JamesGossy/stm32_motor_controller/bench_stm32_esc/bench_stm32_esc.kicad_pcb

## KiCad design bench_stm32_esc/bench_stm32_esc.kicad_pcb (2026-04-23)

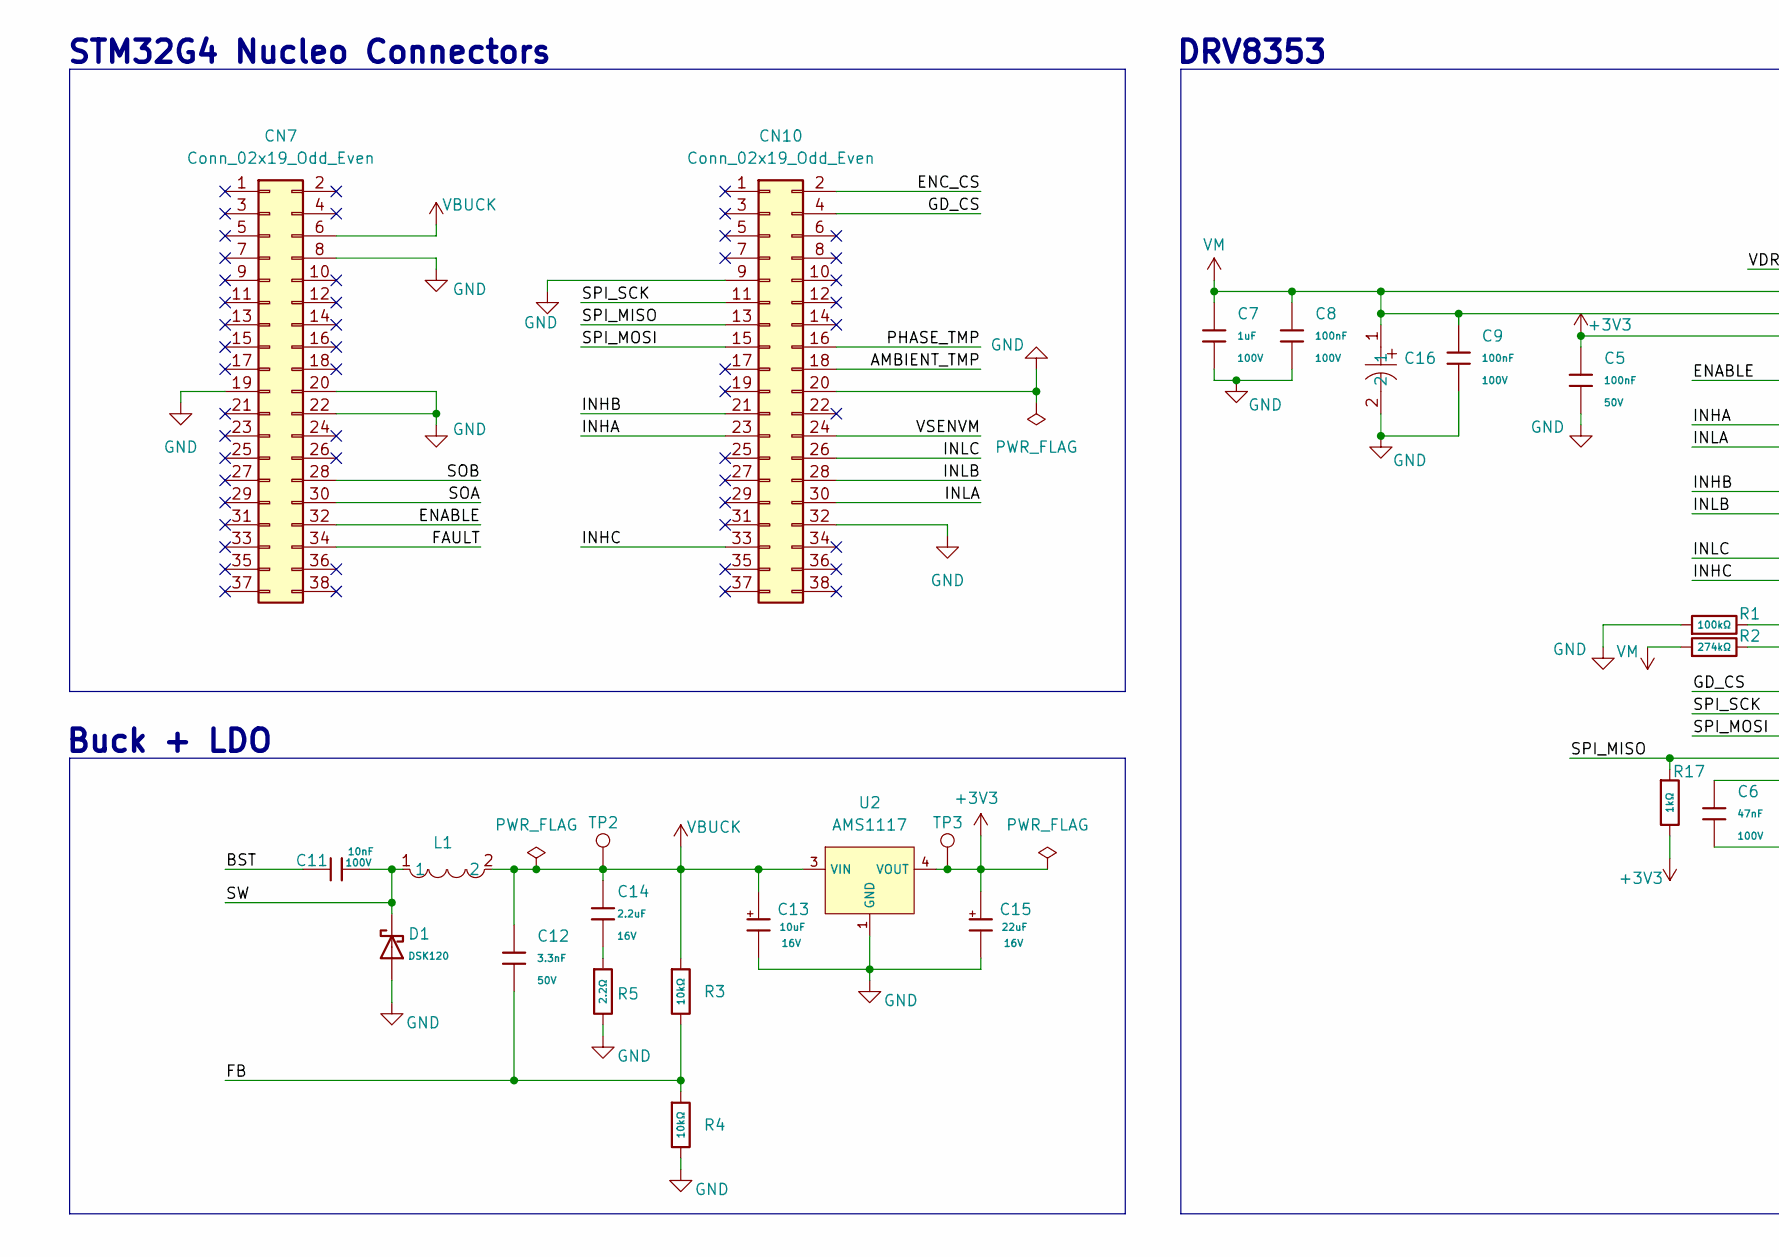
[picture p1: schematic bench_stm32_esc.kicad_sch, part in row 1, column 1]

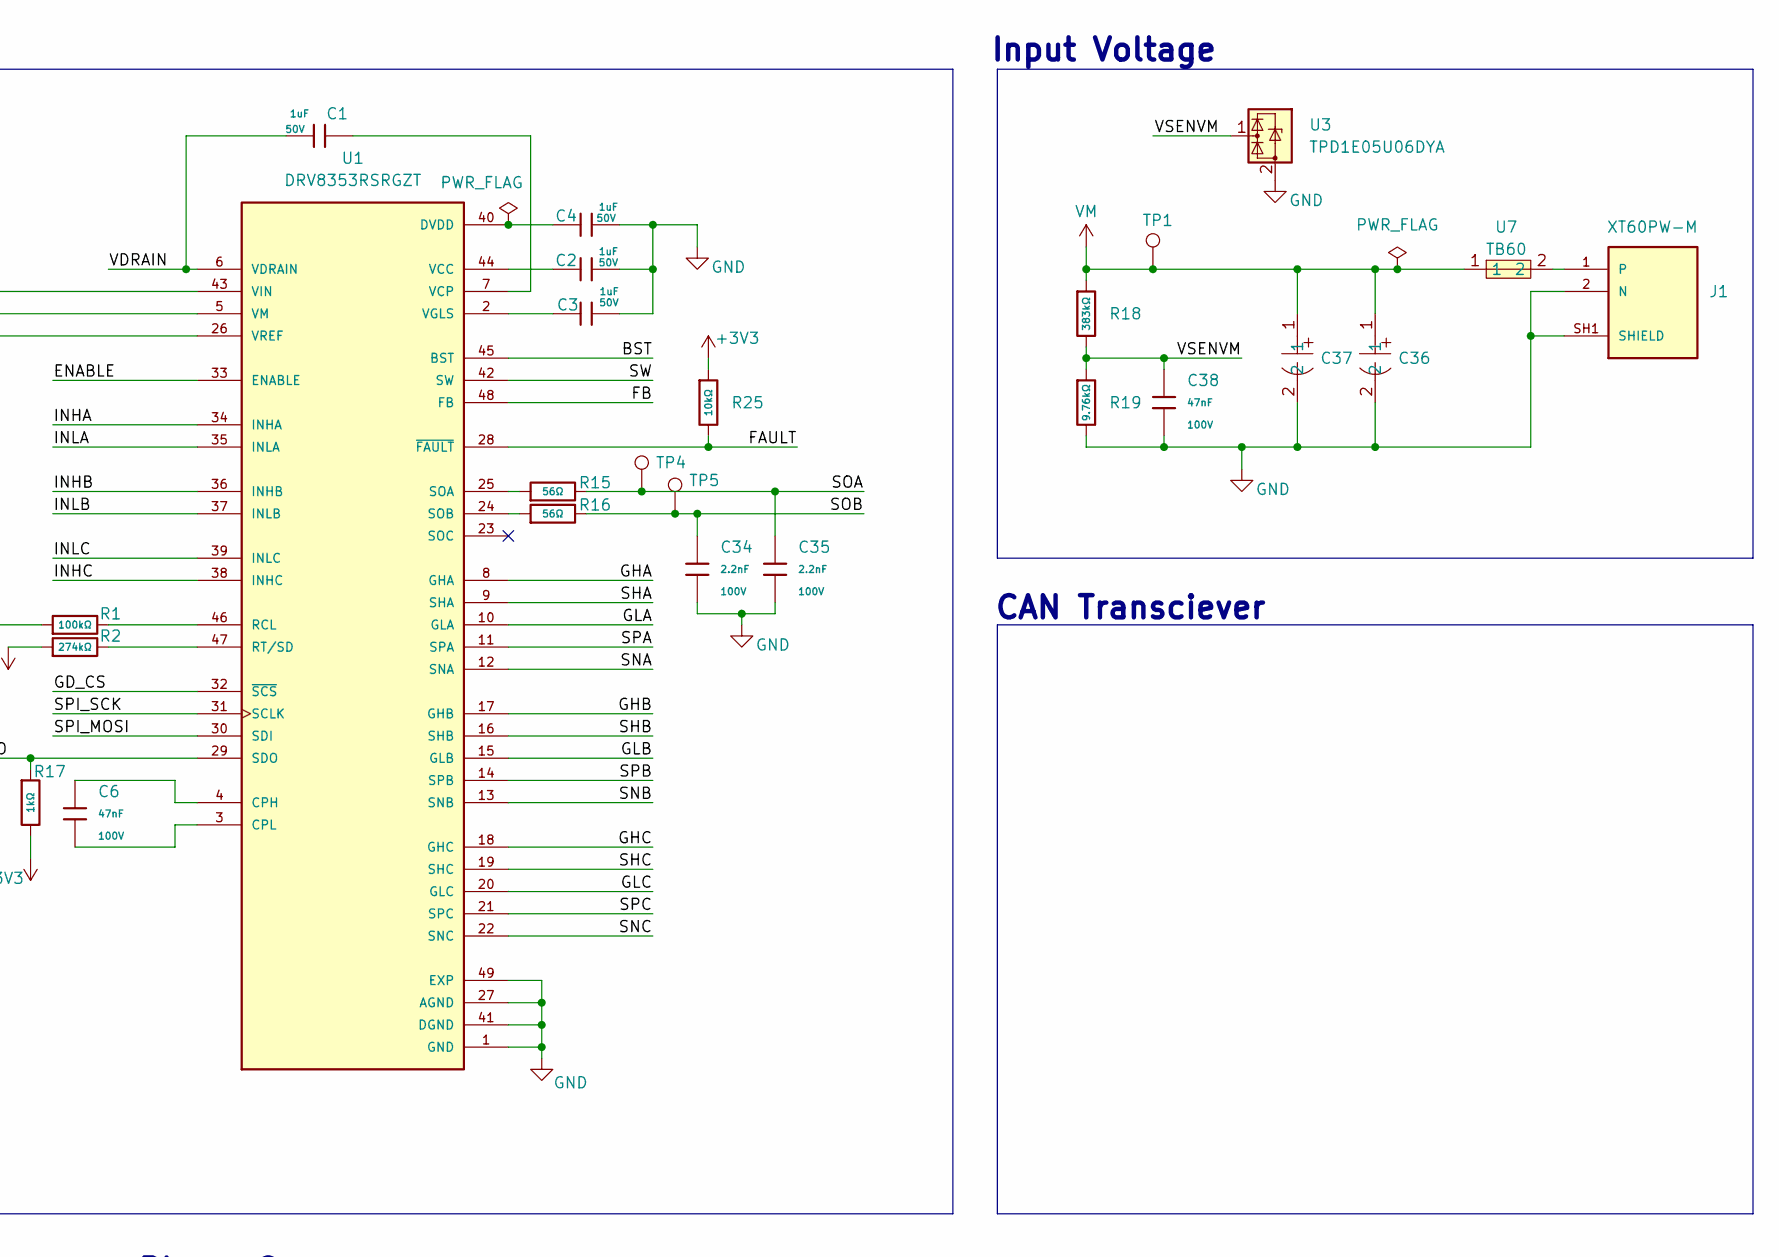
[picture p2: schematic bench_stm32_esc.kicad_sch, part in row 1, column 2]

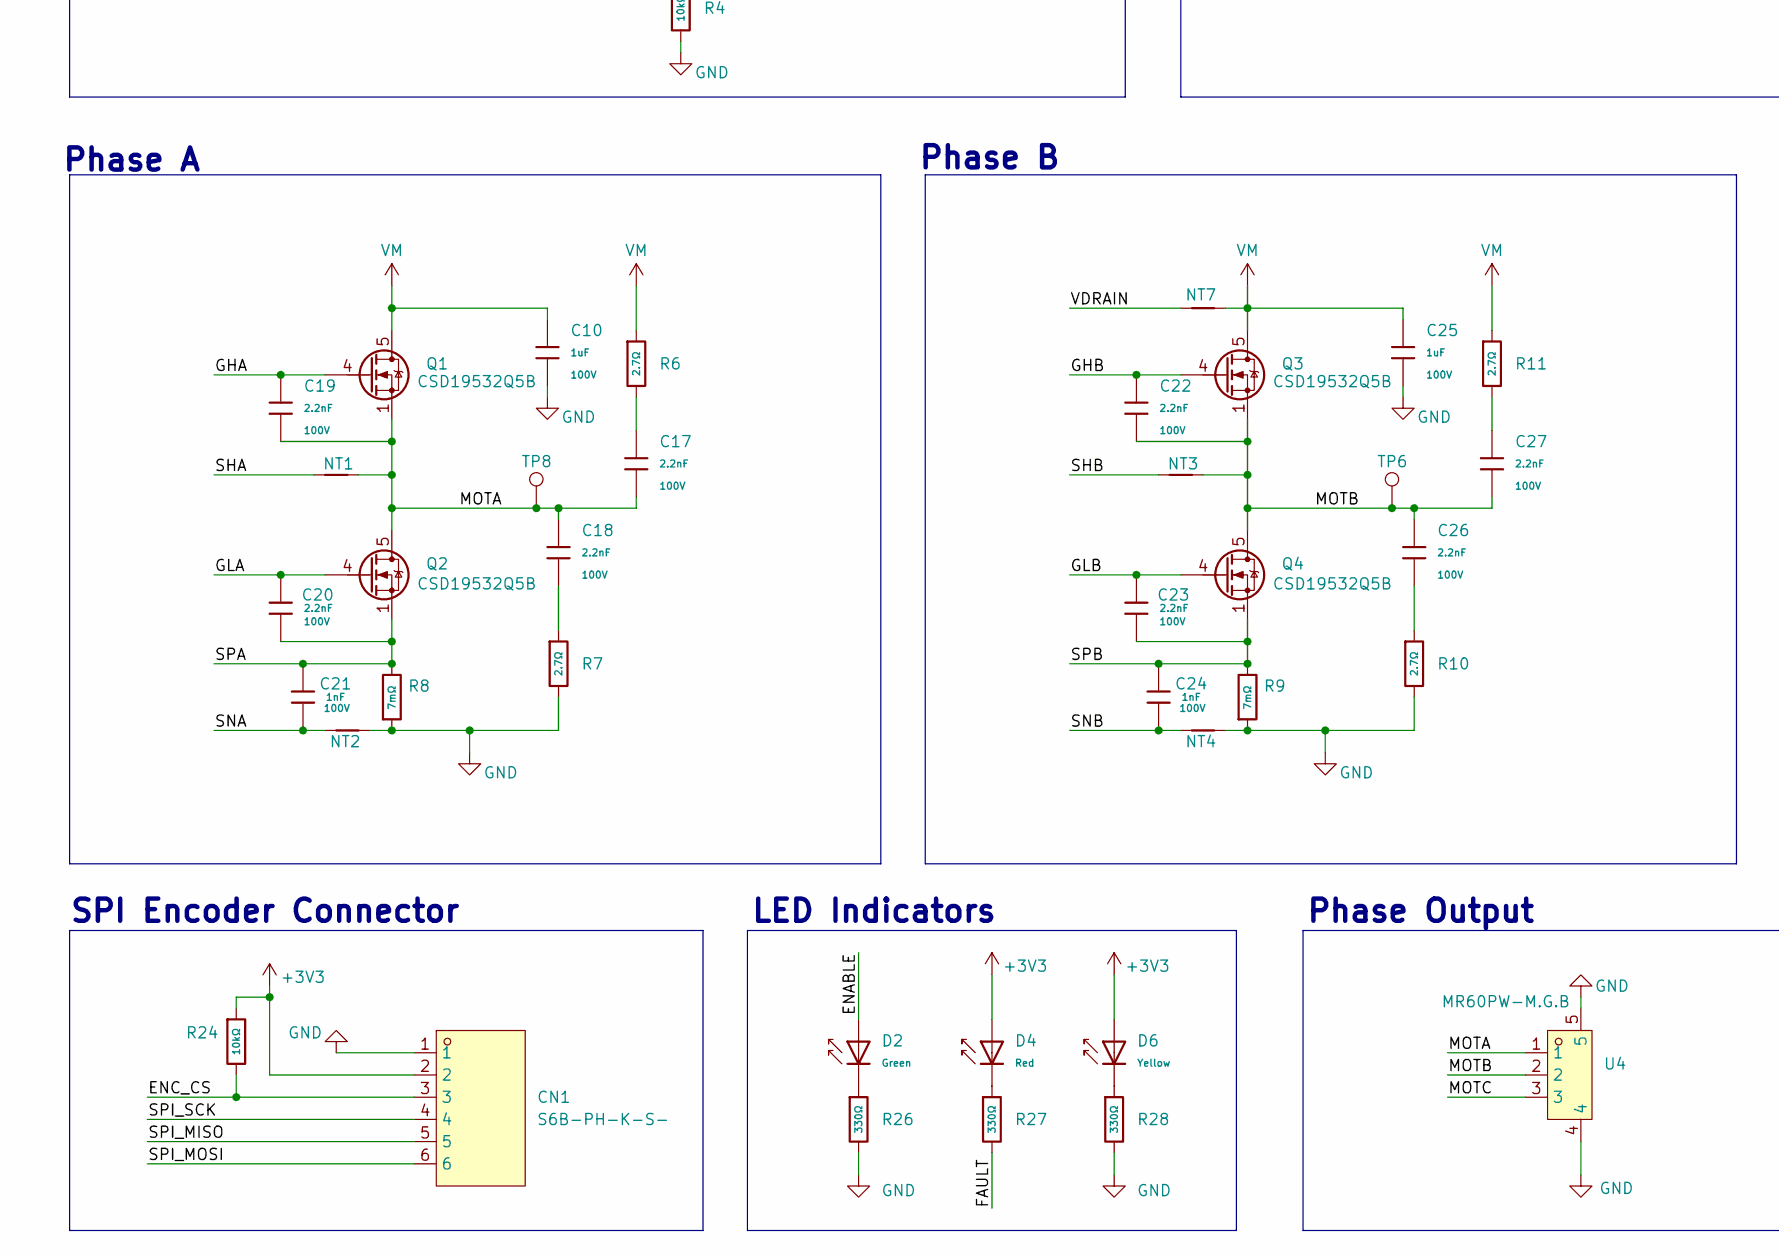
[picture p3: schematic bench_stm32_esc.kicad_sch, part in row 2, column 1]

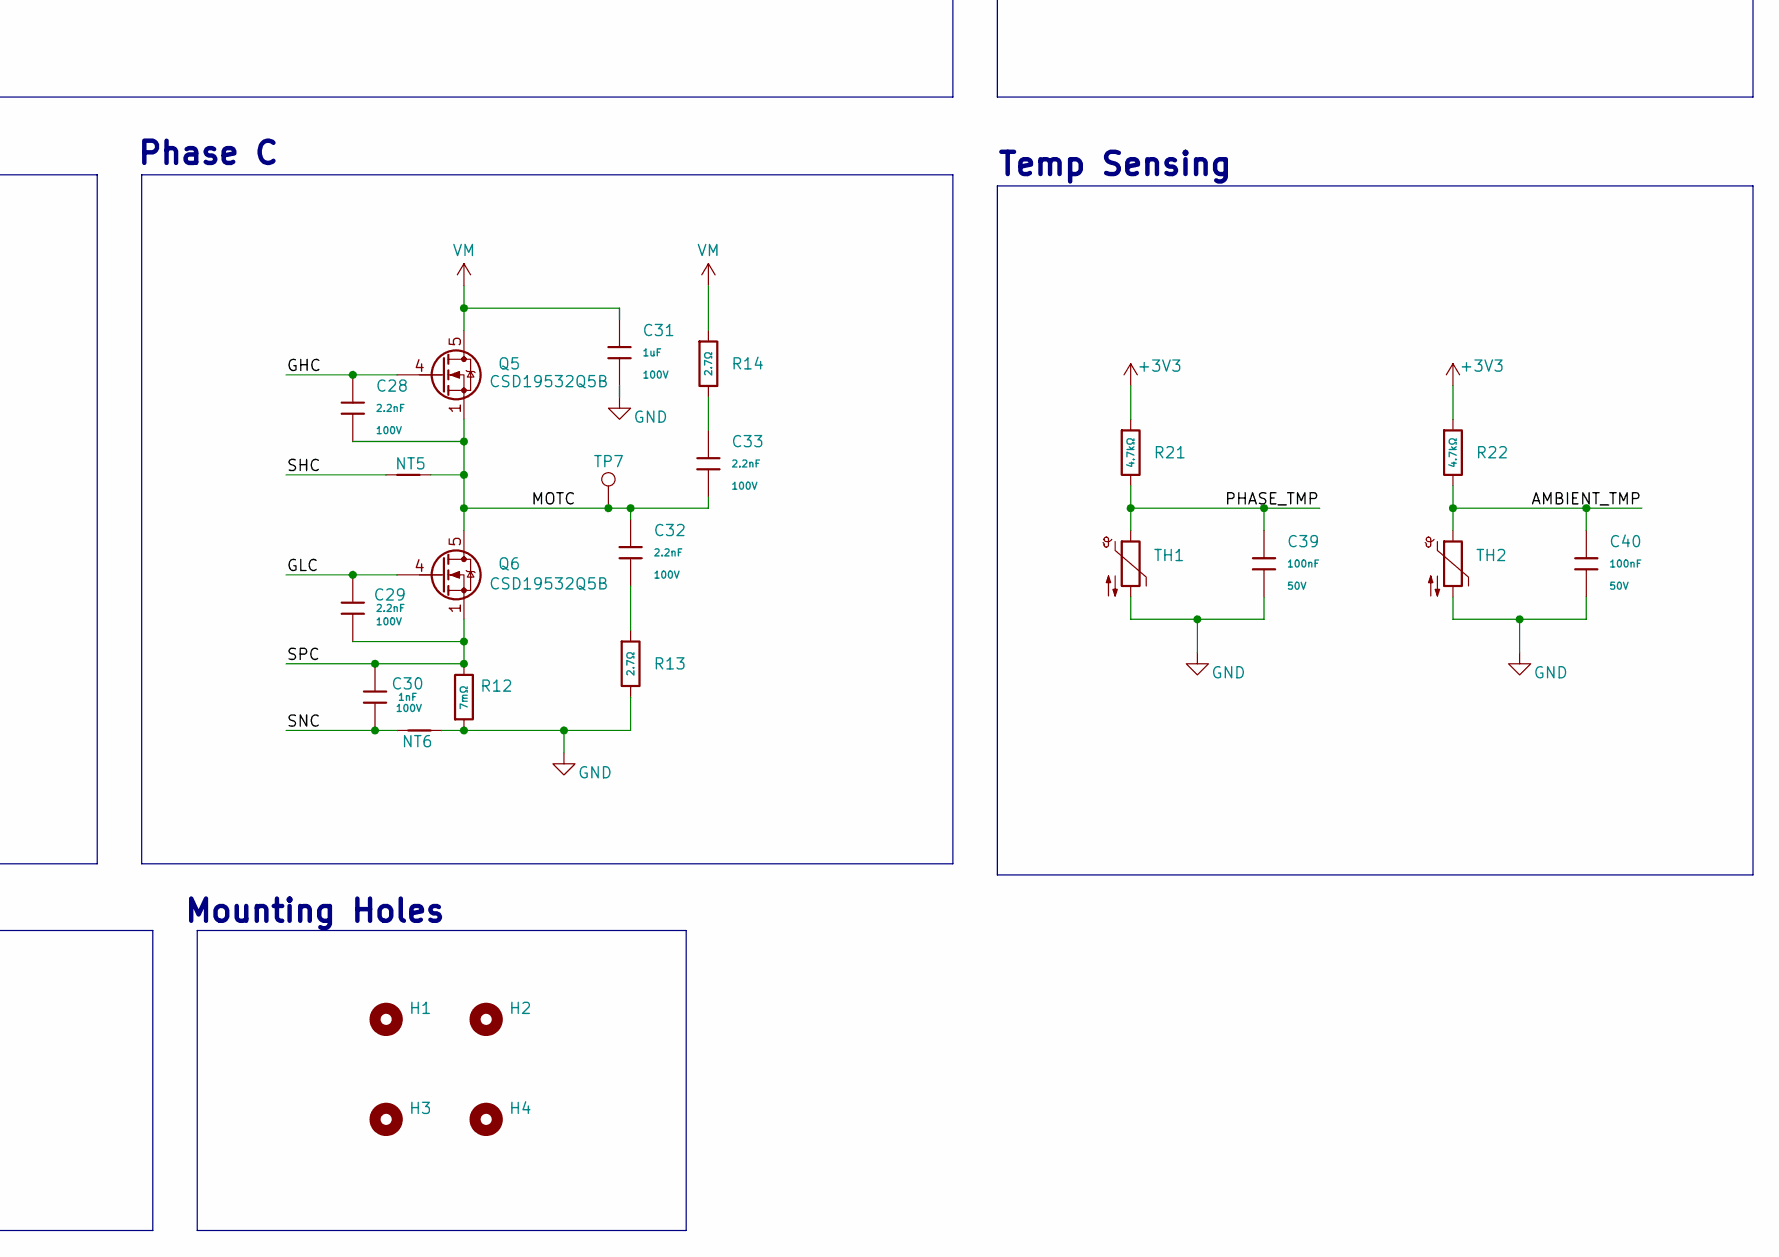
[picture p4: schematic bench_stm32_esc.kicad_sch, part in row 2, column 2]

Parts:
C1, C2, C3, C4: 1uF; C_0603; Voltage Rated 50V; Tolerance ±10%; Part CL10A105KB8NNNC; LCSC C15849
C5, C39, C40: 100nF; C_0603; Voltage Rated 50V; Tolerance ±10%; Part CC0603KRX7R9BB104; LCSC C14663
C6, C38: 47nF; C_0603; Voltage Rated 100V; Tolerance ±10%; Part 0603B473K101CT; LCSC C559308
C7, C10, C25, C31: 1uF; C_0805; Voltage Rated 100V; Tolerance ±10%; Part GCM21BC72A105KE36L; LCSC C126585
C8, C9: 100nF; C_0603; Voltage Rated 100V; Tolerance ±10%; Part CL10B104KC8NNNC; LCSC C15725
C11: 10nF; C_0603; Voltage Rated 100V; Tolerance ±10%; LCSC C43253
C12: 3.3nF; C_0603; Voltage Rated 50V; Tolerance ±10%; Part CL10B332KB8NNNC; LCSC C1613
C13: 10uF; C_CASE-A-3216-18(mm); Tolerance ±10%; Rated Voltage 16V; Part TAJA106K016RNJ; LCSC C7171
C14: 2.2uF; C_0603; Voltage Rated 16V; Tolerance ±10%; Part CL10A225KO8NNNC; LCSC C23630
C15: 22uF; C_CASE-A-3216-18(mm); Tolerance ±10%; Rated Voltage 16V; LCSC C7183
C16: VT10UF100V167RV0127; MPN VT10UF100V167RV0127; LCSC Part C5250958
C17, C18, C19, C20, C22, C23, C26, C27, C28, C29, C32, C33, C34, C35: 2.2nF; C_0603; Voltage Rated 100V; Tolerance ±10%; Part CC0603KRX7R0BB222; LCSC C113804
C21, C24, C30: 1nF; C_0603; Voltage Rated 100V; Tolerance ±10%; Part 0603B102K101NT; LCSC C43847
C36, C37: VEJ331M2ATR-1816; LCSC Part C5266054
CN1: S6B-PH-K-S-; S6B-PH-K-S(LF)(SN); MPN S6B-PH-K-S(LF)(SN); LCSC Part C157920
CN7, CN10: Conn_02x19_Odd_Even; PinSocket_2x19_P2.54mm_Vertical; LCSC C2881762
D1: DSK120; D_SOD-123FL; Part DSK120; LCSC C22466355
D2: Green; D_0805; Part KT-0805G; LCSC C2297
D4: Red; D_0805; Forward Voltage (VF) 1.6V~2.6V; Part NCD0805R1; LCSC C84256
D6: Yellow; D_0805; Part KT-0805Y; LCSC C2296
H1, H2, H3, H4: MountingHole; MountingHole_3.2mm_M3
J1: XT60PW-M; AMASS_XT60PW-M; PARTREV 1.2; LCSC C98732
L1: SMDRH104R-331MT; LCSC Part C10146
NT1, NT2, NT3, NT4, NT5, NT6: NetTie_2; NetTie-2_SMD_Pad0.5mm
NT7: NetTie_2; NetTie-2_SMD_Pad2.0mm
Q1, Q2, Q3, Q4, Q5, Q6: CSD19532Q5B; TDSON-8-1; LCSC C2832190
R1: 100kΩ; R_0603; Tolerance ±1%; LCSC C25803
R2: 274kΩ; R_0603; Tolerance ±1%; LCSC C22968
R3, R4, R24, R25: 10kΩ; R_0603; Overload Voltage (Max) 75V; Tolerance ±1%; Part 0603WAF1002T5E; LCSC C25804
R5: 2.2Ω; R_0603; Overload Voltage (Max) 75V; Tolerance ±1%; Part 0603WAF220KT5E; LCSC C22939
R6, R7, R10, R11, R13, R14: 2.7Ω; R_0805; Overload Voltage (Max) 150V; Tolerance ±1%; Part 0805W8F270KT5E; LCSC C17532
R8, R9, R12: 7mΩ; R_2512_6332Metric; Part No RLP25FEGMR007; LCSC C393073
R15, R16: 56Ω; R_0603; Overload Voltage (Max) 75V; Tolerance ±1%; Part 0603WAF560JT5E; LCSC C25196
R17: 1kΩ; R_0603; Overload Voltage (Max) 75V; Tolerance ±1%; Part 0603WAF1001T5E; LCSC C21190
R18: 383kΩ; R_0805; Overload Voltage (Max) 150V; Tolerance ±1%; Part 0805W8F3833T5E; LCSC C17652
R19: 9.76kΩ; R_0805; Overload Voltage (Max) 150V; Tolerance ±1%; Part 0805W8F9761T5E; LCSC C17859
R21, R22: 4.7kΩ; R_0603; Overload Voltage (Max) 75V; Tolerance ±1%; Part 0603WAF4701T5E; LCSC C23162
R26, R27, R28: 330Ω; R_0603; Overload Voltage (Max) 75V; Tolerance ±1%; Part 0603WAF3300T5E; LCSC C23138
TH1, TH2: Thermistor_NTC; R_0603; Part No KNTC0603/10KF3950; LCSC C2892547
TP1, TP2, TP3, TP4, TP5, TP6, TP7, TP8: TestPoint; TestPoint_Pad_1.5x1.5mm
U1: DRV8353RSRGZT; QFN50P700X700X100-49N; PARTREV A; LCSC C2150650
U2: AMS1117; SOT-223-3_L6.5-W3.4-P2.30-LS7.0-BR; Output Voltage 3.3V; Dropout Voltage 1.3V@(800mA); Part AMS1117-3.3; LCSC C6186
U3: TPD1E05U06DYA; D_SOD-523
U4: MR60PW-M.G.B; CONN-TH_MR60PW; LCSC Part C19268044
U7: TB60; LCSC Part C2998193

Connections:
+3V3: C5.1, C15.1, CN1.2, D4.2, D6.2, R17.2, R21.1, R22.1, R24.1, R25.1, TP3.1 (1_1), U1.26 (VREF), U2.2 (VOUT), U2.4 (VOUT)
/AMBIENT_TMP: C40.1, CN10.18, R22.2, TH2.1
/BST: C11.1, U1.45 (BST)
/ENABLE: CN7.32, D2.2, U1.33 (ENABLE)
/ENC_CS: CN1.3, CN10.2, R24.2
/FAULT: CN7.34, R25.2, R27.2, U1.28 (~FAULT)
/FB: C12.2, R3.2, R4.1, U1.48 (FB)
/GD_CS: CN10.4, U1.32 (~SCS)
/GHA: C19.1, Q1.4 (G), U1.8 (GHA)
/GHB: C22.1, Q3.4 (G), U1.17 (GHB)
/GHC: C28.1, Q5.4 (G), U1.18 (GHC)
/GLA: C20.1, Q2.4 (G), U1.10 (GLA)
/GLB: C23.1, Q4.4 (G), U1.15 (GLB)
/GLC: C29.1, Q6.4 (G), U1.20 (GLC)
/INHA: CN10.23, U1.34 (INHA)
/INHB: CN10.21, U1.36 (INHB)
/INHC: CN10.33, U1.38 (INHC)
/INLA: CN10.30, U1.35 (INLA)
/INLB: CN10.28, U1.37 (INLB)
/INLC: CN10.26, U1.39 (INLC)
/MOTA: C17.2, C18.1, C19.2, NT1.2, Q1.1 (S), Q1.2 (S), Q1.3 (S), Q2.5 (D), TP8.1 (1_1), U4.1
/MOTB: C22.2, C26.1, C27.2, NT3.2, Q3.1 (S), Q3.2 (S), Q3.3 (S), Q4.5 (D), TP6.1 (1_1), U4.2
/MOTC: C28.2, C32.1, C33.2, NT5.2, Q5.1 (S), Q5.2 (S), Q5.3 (S), Q6.5 (D), TP7.1 (1_1), U4.3
/PHASE_TMP: C39.1, CN10.16, R21.2, TH1.1
/SHA: NT1.1, U1.9 (SHA)
/SHB: NT3.1, U1.16 (SHB)
/SHC: NT5.1, U1.19 (SHC)
/SNA: C21.2, NT2.1, U1.12 (SNA)
/SNB: C24.2, NT4.1, U1.13 (SNB)
/SNC: C30.2, NT6.1, U1.22 (SNC)
/SOA: C35.1, CN7.30, R15.2, TP4.1 (1_1)
/SOB: C34.1, CN7.28, R16.2, TP5.1 (1_1)
/SPA: C20.2, C21.1, Q2.1 (S), Q2.2 (S), Q2.3 (S), R8.1, U1.11 (SPA)
/SPB: C23.2, C24.1, Q4.1 (S), Q4.2 (S), Q4.3 (S), R9.1, U1.14 (SPB)
/SPC: C29.2, C30.1, Q6.1 (S), Q6.2 (S), Q6.3 (S), R12.1, U1.21 (SPC)
/SPI_MISO: CN1.5, CN10.13, R17.1, U1.29 (SDO)
/SPI_MOSI: CN1.6, CN10.15, U1.30 (SDI)
/SPI_SCK: CN1.4, CN10.11, U1.31 (SCLK)
/SW: C11.2, D1.1, L1.1, U1.42 (SW)
/VDRAIN: C1.1, NT7.1, U1.6 (VDRAIN)
/VSENVM: C38.1, CN10.24, R18.2, R19.1, U3.1 (I/O)
GND: C2.2, C3.2, C4.2, C5.2, C7.2, C8.2, C9.2, C10.2, C13.2, C15.2, C16.2, C25.2, C31.2, C34.2, C35.2, C36.2, C37.2, C38.2, C39.2, C40.2, CN1.1, CN7.8, CN7.19, CN7.20, CN7.22, CN10.9, CN10.20, CN10.32, D1.2, J1.2 (N), J1.SH1 (SHIELD), J1.SH2 (SHIELD), NT2.2, NT4.2, NT6.2, R1.1, R4.2, R5.2, R7.2, R8.2, R9.2, R10.2, R12.2, R13.2, R19.2, R26.2, R28.2, TH1.2, TH2.2, U1.1 (GND), U1.27 (AGND), U1.41 (DGND), U1.49 (EXP), U2.1 (GND), U3.2 (GND), U4.4, U4.5
unnamed: C14.2, R5.1
unnamed: C17.1, R6.2
unnamed: C18.2, R7.1
unnamed: C26.2, R10.1
unnamed: C27.1, R11.2
unnamed: C32.2, R13.1
unnamed: C33.1, R14.2
unnamed: D2.1, R26.1
unnamed: D4.1, R27.1
unnamed: D6.1, R28.1
unnamed: J1.1, U7.2
unnamed: C6.1, U1.4 (CPH)
unnamed: C6.2, U1.3 (CPL)
unnamed: C4.1, U1.40 (DVDD)
unnamed: R1.2, U1.46 (RCL)
unnamed: R2.2, U1.47 (RT/SD)
unnamed: R15.1, U1.25 (SOA)
unnamed: R16.1, U1.24 (SOB)
unnamed: C2.1, U1.44 (VCC)
unnamed: C1.2, U1.7 (VCP)
unnamed: C3.1, U1.2 (VGLS)
VBUCK: C12.1, C13.1, C14.1, CN7.6, L1.2, R3.1, TP2.1 (1_1), U2.3 (VIN)
VM: C7.1, C8.1, C9.1, C10.1, C16.1, C25.1, C31.1, C36.1, C37.1, NT7.2, Q1.5 (D), Q3.5 (D), Q5.5 (D), R2.1, R6.1, R11.1, R14.1, R18.1, TP1.1 (1_1), U1.5 (VM), U1.43 (VIN), U7.1

Notes on the sheet:
Phase A
Phase Output
STM32G4 Nucleo Connectors
SPI Encoder Connector
CAN Transciever
Buck + LDO
LED Indicators
DRV8353
Input Voltage
Phase B
Temp Sensing
Phase C
Mounting Holes

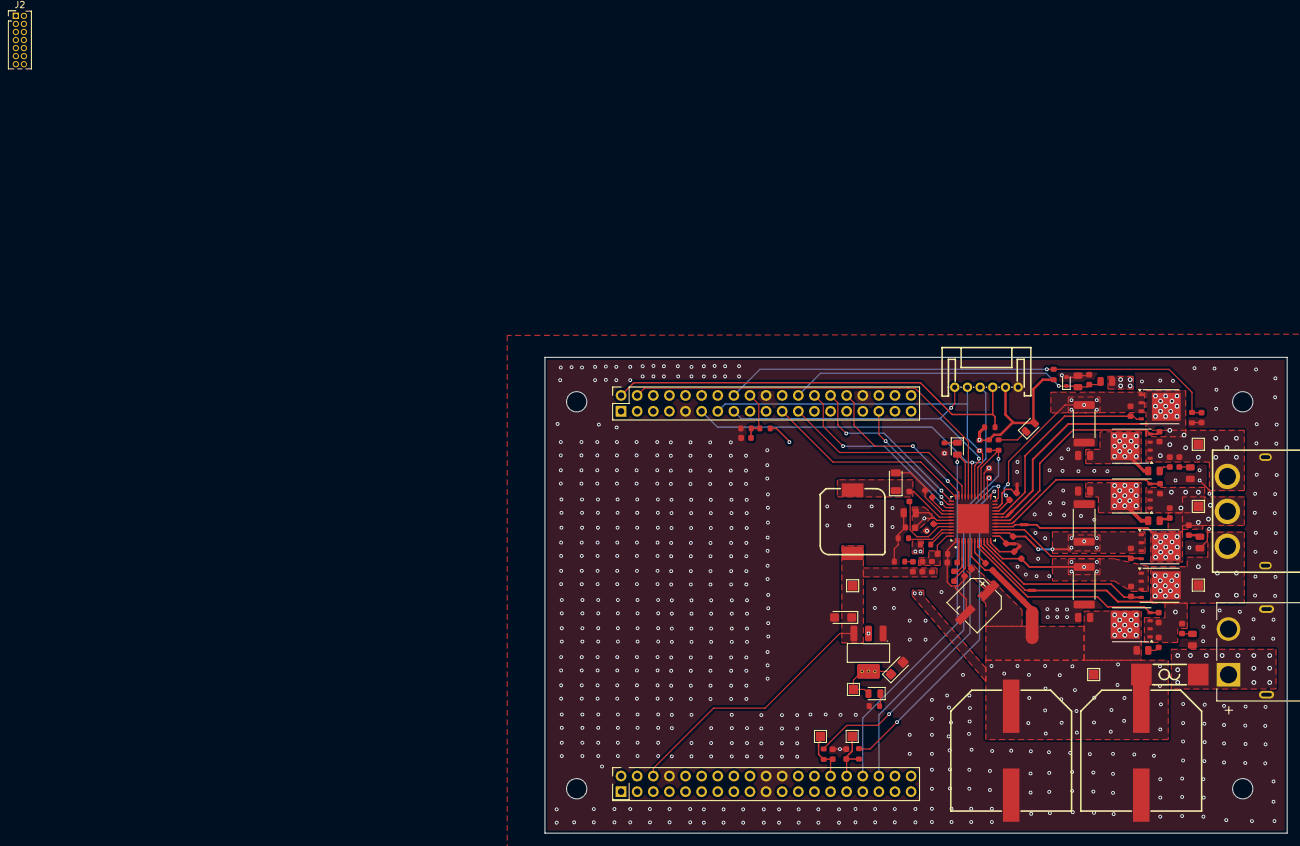
[picture p5: board bench_stm32_esc.kicad_pcb from above]

Board: 4 copper layers, 117.0 x 75.0 mm, 108 parts (0 on the bottom side), 66 nets.

Other parts of the board:
J2: Conn_ST_STDC14; PinHeader_2x07_P1.27mm_Vertical

Their connections:
unnamed: J2.5 (GND), J2.7 (GND)
