JamesGossy/stm32_motor_controller/stm32_code/stm32_code.ioc

Mcu.UserName=STM32G474RETx
PA0.GPIO_Label=SOB
PA0.Signal=ADC1_IN1
PA1.GPIO_Label=SOA
PA1.Signal=ADC2_IN2
PA10.Signal=S_TIM1_CH3
PA13.GPIO_Label=T_SWDIO
PA13.Signal=SYS_JTMS-SWDIO
PA14.GPIO_Label=T_SWCLK
PA14.Signal=SYS_JTCK-SWCLK
PA2.Signal=LPUART1_TX
PA3.Signal=LPUART1_RX
PA4.GPIO_Label=ENABLE
PA4.Signal=GPIO_Output
PA8.Signal=S_TIM1_CH1
PA9.Signal=S_TIM1_CH2
PB0.GPIO_Label=FAULT
PB0.Signal=GPIO_Input
PB1.GPIO_Label=VSENVM
PB1.Signal=ADC3_IN1
PB11.GPIO_Label=AMBIENT_TMP
PB11.Signal=ADC2_IN14
PB12.GPIO_Label=PHASE_TMP
PB12.Signal=ADC4_IN3
PB13.Signal=TIM1_CH1N
PB14.Signal=TIM1_CH2N
PB15.Signal=TIM1_CH3N
PB3.GPIO_Label=T_SWO
PB3.Signal=SYS_JTDO-SWO
PC14-OSC32_IN.GPIO_Label=RCC_OSC32_IN
PC14-OSC32_IN.Signal=RCC_OSC32_IN
PC15-OSC32_OUT.GPIO_Label=RCC_OSC32_OUT
PC15-OSC32_OUT.Signal=RCC_OSC32_OUT
PC6.GPIO_Label=GD_CS
PC6.Signal=GPIO_Output
PC8.GPIO_Label=ENC_CS
PC8.Signal=GPIO_Output
PF0-OSC_IN.GPIO_Label=RCC_OSC_IN
PF0-OSC_IN.Signal=RCC_OSC_IN
PF1-OSC_OUT.GPIO_Label=RCC_OSC_OUT
PF1-OSC_OUT.Signal=RCC_OSC_OUT
