JamesGossy/stm32_motor_controller/bldc_controller/Inc/hal/hal_init.h

#pragma once

#include <stdint.h>

void SystemClock_Config(void);
void GPIO_Init(void);
void TIM1_Init(void);

/* Peripheral fault input — nFAULT is active-low on PB0 */
#define GD_NFAULT_ACTIVE()  (!(GPIOB->IDR & (1u << 0)))
