JamesGossy/stm32_motor_controller/(commit log)

2026-04-12 First PCB Revision
    [BOM-bench_stm32_esc.csv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]
2026-04-23 Fixed 5V input to NUCLEO Board
    [bench_stm32_esc.kicad_pcb, bench_stm32_esc.kicad_sch]
